dmitriynett-sudo/gitara-els/README.md

# GITARA — Electronic Lead Screw (ELS), электронная гитара для токарного станка

Electronic Lead Screw (ELS), или электронные шестерни для токарного станка, связывает движение продольной каретки с вращением шпинделя и заменяет подбор механических сменных шестерён для подачи и резьбы.

Проект управляет **одной осью — продольной подачей каретки**. Возможности: нарезание и восстановление резьбы, перемещение на заданное расстояние и деление оборота шпинделя.

GITARA управляет шаговым двигателем продольной подачи по энкодеру шпинделя или по заданной скорости. Управление приводом шпинделя и поперечной подачей остаётся у оператора.

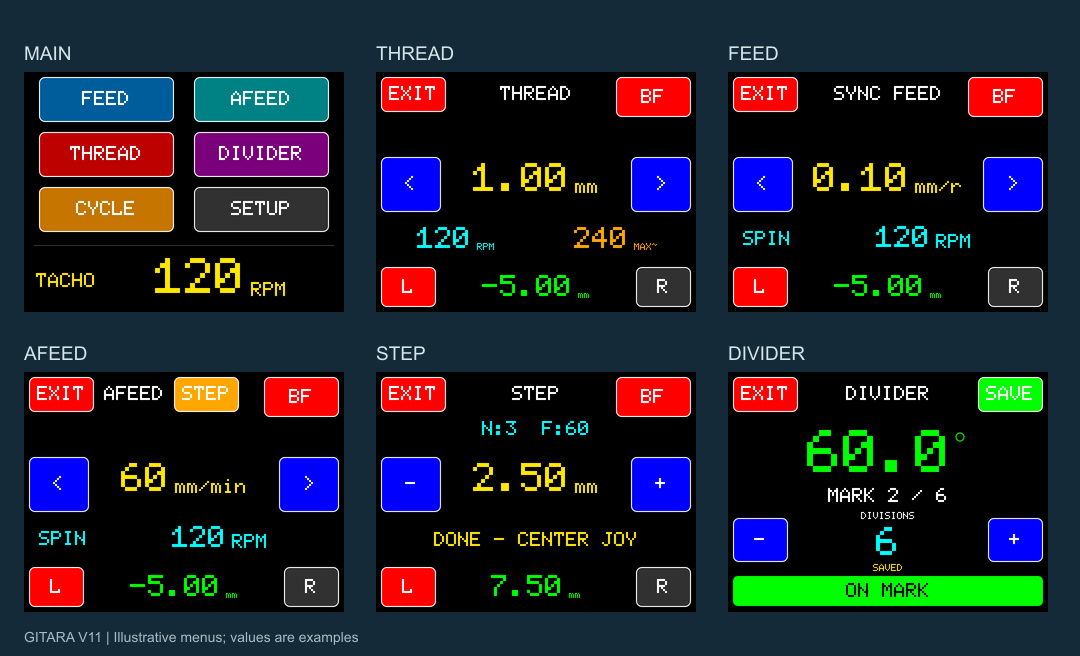
[picture p1: images/menus-v11.png]
Иллюстрации меню GITARA V11


## Документация

- [Фото установки и видео меню на станке](https://dmitriynett-sudo.github.io/gitara-els/#installation) — пример крепления энкодера, передачи продольной подачи и панели управления.

- **[Схема и плата ELS R6: полный проект KiCad, ZIP](hardware/ELS_R6/ELS_R6_KiCad.zip)** — 4 листа схемы, двухслойная плата 58×38 мм и библиотеки компонентов.
- [Схема ELS R6, PDF](hardware/ELS_R6/ELS_R6_Schematic.pdf) · [Файлы KiCad, Gerber и монтажные карты](hardware/ELS_R6/) · [Распиновка разъёмов](hardware/ELS_R6/CONNECTIONS_RU.md).
- Кронштейны: [двигатель NEMA23, DXF](drawings/nema23-bracket.dxf) · [энкодер, DXF](drawings/encoder-bracket.dxf). Единицы — мм; посадочные размеры сверяются со своей механикой.

- **[Открыть виртуальную GITARA V11](https://dmitriynett-sudo.github.io/gitara-els/)** — полный набор меню, настройки, виртуальный шпиндель, джойстик, микроподача и примеры работы. Браузерная модель не управляет станком и не воспроизводит точность/защиту прошивки.
- [Инструкция пользователя V11, PDF](docs/GITARA_V11_User_Guide_RU.pdf) — настройка под свой станок и обзор меню.
- [Сборка и подключение ELS R6](hardware/ELS_R6/README.md) · [Список деталей](hardware/ELS_R6/BOM.csv).
- [Первое включение](docs/QUICK_START_RU.md).
- [Установка готовой прошивки](docs/INSTALL_FIRMWARE_RU.md).
- [Изменения V11](CHANGELOG.md).

Значения на иллюстрациях приведены для примера. Настройки нужно вводить по механике, энкодеру и драйверу своего станка.

## Возможности

| Режим | Назначение |
| --- | --- |
| FEED | Синхронная подача в мм на оборот шпинделя; изменение подачи во время движения. |
| AFEED | Независимая подача в мм/мин. |
| THREAD | Метрические и дюймовые резьбы, правая и левая резьба; сохранение привязки между проходами в выбранном режиме. |
| STEP | Перемещение на заданное расстояние: канавки, шкивы, повторяющиеся операции. |
| DIVIDER | Число делений оборота, угол и звуковое подтверждение попадания на деление. |
| CYCLE | Движение между двумя электронными лимитами с паузой. |
| BF | Компенсация измеренного люфта; мастер начальной настройки. |
| SETUP | Параметры механики, разгон, торможение, диагностика, SD-лог и регистрация. |

## Совместимость

Текущая аппаратная реализация рассчитана на Waveshare RP2350-Touch-LCD-2, квадратурный энкодер A/B и драйвер шагового двигателя с входами STEP/DIR/ENA. Совместимость уровней сигналов и соединения проверяются по паспорту платы и драйвера. Подключение энкодера или драйвера напрямую без проверки уровней может повредить плату.

Нужная плата: **[Waveshare RP2350-Touch-LCD-2, экран 2″ 240×320](https://www.waveshare.com/product/rp2350-touch-lcd-2.htm)**. [Документация и распиновка производителя](https://www.waveshare.com/wiki/RP2350-Touch-LCD-2). Модели 2.1, 2.8 и другие платы не являются заменой для этого UF2.

## Прошивка и активация

**[Скачать GITARA V11 DEMO для RP2350](https://github.com/dmitriynett-sudo/gitara-els/releases/tag/v11-demo-rc1)**. В разделе Assets находятся готовая прошивка UF2, инструкция PDF и контрольные суммы файлов. Для установки скачайте UF2; архивы Source code содержат документацию.

В версии для распространения предусмотрен демонстрационный режим: FEED 0,10 мм/об, AFEED, DIVIDER и THREAD 1,00 мм. Другие шаги резьбы, подачи FEED и режимы STEP/CYCLE открываются активацией для конкретной платы.

Для активации используется DEVICE ID из раздела REGISTER и восьмизначный код, который вводится на экране. Интернет на станке для ввода кода не требуется. Не публикуйте свои коды активации и платёжные данные в Issues.

## Проверка на станке

Перед резанием проверьте направление движения, масштаб DRO и работу лимитов без контакта инструмента с заготовкой. DRO показывает расчётное положение по выданным импульсам; датчика фактического положения каретки нет. Электронные лимиты не заменяют аварийную остановку станка.

## Обратная связь

В Issues можно сообщить о неисправности или предложить улучшение. Укажите версию, режим, настройки механики, выбранную подачу/шаг и порядок воспроизведения. Перед публикацией лога удалите личные данные, идентификаторы плат и коды активации.

## Активация полной версии прошивки

Пользователь самостоятельно собирает устройство и проверяет деморежим. Если прошивка подходит для его задач, он может активировать полную версию.

Стоимость **активации прошивки — 10 долларов**, оплата в **USDT, сеть BNB Smart Chain (BEP20)**. Перед переводом отправьте DEVICE ID из SETUP → REGISTER на [dmitriynet@proton.me](mailto:dmitriynet@proton.me) и согласуйте сумму в USDT. После подтверждения перевода код выдаётся вручную; код привязан к этой плате.

Адрес получения:

`0x5408C962E5A43E652782C84E41e1a12F8a28AdDa`

После оплаты пришлите на почту TXID транзакции и DEVICE ID. Используйте только USDT в BNB Smart Chain; комиссия сети оплачивается отдельно. [Порядок активации на странице проекта](https://dmitriynett-sudo.github.io/gitara-els/#activation).
