dmitriynett-sudo/gitara-els/hardware/ELS_R6/CHECKS_RU.md

# Проверка переноса ELS R6 в KiCad

Проверено в KiCad 10.0.7. Основа - архив ELS_R6_EasyEDA_STD.zip.

- Четыре листа схемы перенесены из EasyEDA в редактируемую схему KiCad.
- Все 169 уникальных выводов совпадают с исходным PIN_NETLIST.csv, включая пять намеренно неподключённых выводов U201.
- Сохранены размещение, геометрия контактных площадок, дорожки, переходные отверстия, зоны меди и контур исходной платы KiCad.
- Добавлены ссылки платы на символы схемы и локальные библиотеки; R238/R239 отмечены DNP. Пяти неподключённым площадкам присвоены стандартные имена KiCad `unconnected-...`.
- DRC: 0 нарушений, 0 неподключённых элементов. Сверка схемы с платой: 0 расхождений.
- ERC: 0 ошибок, 1 предупреждение об одиночной метке ELS_LCD_SCK18 у U201.23. Эта цепь не подключена к внешним деталям, как и в исходном проекте.

Сетка схемы приведена к 50 mil для редактирования в KiCad. Электрические типы выводов
импортированных символов - passive, как в исходных данных: ERC не подтверждает совместимость
напряжений и направления сигналов. CAD-проверки не заменяют электрические испытания устройства и защиты питания.
