dmitriynett-sudo/gitara-els/hardware/ELS_R6/CONNECTIONS_RU.md

# Разъёмы ELS R6

## ELS Pi R6

Разъёмы находятся на TOP — задней стороне. В указанных ниже вертикальных
разъёмах порядок дан **сверху вниз на TOP**. Квадратная площадка — контакт 1.

| Разъём | Контакты | Подписи |
|---|---|---|
| U205 DRIVER | 1 +5V; 2 STEP; 3 ENA; 4 DIR | +5, STP, ENA, DIR слева от контактов |
| U206 ENCODER | 1 +5V; 2 A; 3 B; 4 GND | +5, A, B, GND справа от контактов |
| J204 EXT | 1 3V3; 2 GND; 3 SDA/GP12; 4 SCL/GP13; 5 GP11; 6 GP23; 7 GP21; 8 IN_RESERVED | 3V3, GND, SDA, SCL, GP11, GP23, GP21, IN5 |
| CN201 VIN | TOP слева 1 +36V, справа 2 GND | +36 и GND ниже контактов |

IN5 — вход через согласователь к GPIO5, а не свободный выход процессора.
GPIO11/21/23 доступны при отключённой камере. I²C общий с модулем; уровни 3,3 В.
**R238/R239 (DNP) не устанавливать**: подтяжки уже имеются в Waveshare.
Кнопки и тумблер находятся на BOTTOM. Порядок выводов драйвера и энкодера сохранён.
Питание 36 В подаётся только на CN201 VIN; подавать его на выводы модуля Waveshare и сигнальные разъёмы нельзя.

Монтажные карты показывают позиции деталей. TOP - задняя сторона с разъёмами,
BOTTOM - сторона кнопок и тумблера. Плата Waveshare устанавливается поперёк несущей платы.

Узел защиты R6: выход M201.3 -> F202 -> +5V. Z201: катод (вывод 1, полоса)
к защищённым +5V, анод (вывод 2) к GND. F202 - быстрый 500 мА, не самовосстанавливающийся.
