dmitriynett-sudo/gitara-els/docs/QUICK_START_RU.md

# Первое включение

Полное описание и иллюстрации меню находятся в [инструкции пользователя](GITARA_V11_User_Guide_RU.pdf).

1. Подключите питание, энкодер и драйвер по паспорту платы. Двигатель подключается к драйверу. Установите ток двигателя и делитель микрошага на драйвере.
2. Оставьте джойстик в нейтрали, отведите инструмент от заготовки. В SETUP отключите SIMULATOR.
3. Введите механические параметры:
   - **SCREW PITCH** — шаг обычного однозаходного ходового винта продольной подачи. Винт 2 мм → 2,00. Это не шаг резьбы на заготовке.
   - **MOTOR STEPS** — полные шаги двигателя за оборот: 1,8° → 200; 0,9° → 400.
   - **MICROSTEP** — делитель, установленный на драйвере.
   - **MOTOR GEAR / SCREW GEAR** — зубья на стороне двигателя / винта; для прямого соединения одинаковые числа.
   - **ENC LINES** = паспортные линии энкодера × зубья шкива шпинделя / зубья шкива энкодера. Пример: 1000 × 40 / 20 = 2000. Дополнительно умножать на 2 или 4 не нужно.
4. Сохраните настройки кнопкой SAVE при остановленном шпинделе и отпущенном управлении.
5. В DIVIDER проверьте угол по метке шпинделя: половина оборота — 180°, полный оборот — ровно один круг 0–360°.
6. С BF OFF и BACKLASH = 0 проверьте в AFEED направление и известное расстояние движения. Люфт перед измерением выбирайте движением в ту же сторону. Сравните DRO с измерительным инструментом.
7. Измерьте и настройте BACKLASH. Включение BF — удержание кнопки около 1,2 секунды при отпущенном управлении. Значение уточняйте по индикатору.
8. Задайте безопасные лимиты L/R удержанием соответствующей кнопки около 2,2 секунды. Проверьте остановку до резания. Обнуление DRO, изменение масштаба и перезапуск снимают лимиты.
9. Для резьбы выберите шаг в THREAD, совместите инструмент с началом канавки и проверьте траекторию ручным вращением шпинделя без резания. Повторные проходы выполняются с той же настройкой THREAD и сохранённой привязкой.

Показание MAX в THREAD — расчётный ориентир. Допустимая скорость также зависит от механики, нагрузки, двигателя и драйвера.
