dmitriynett-sudo/gitara-els/hardware/ELS_R6/PCB_TOP.png

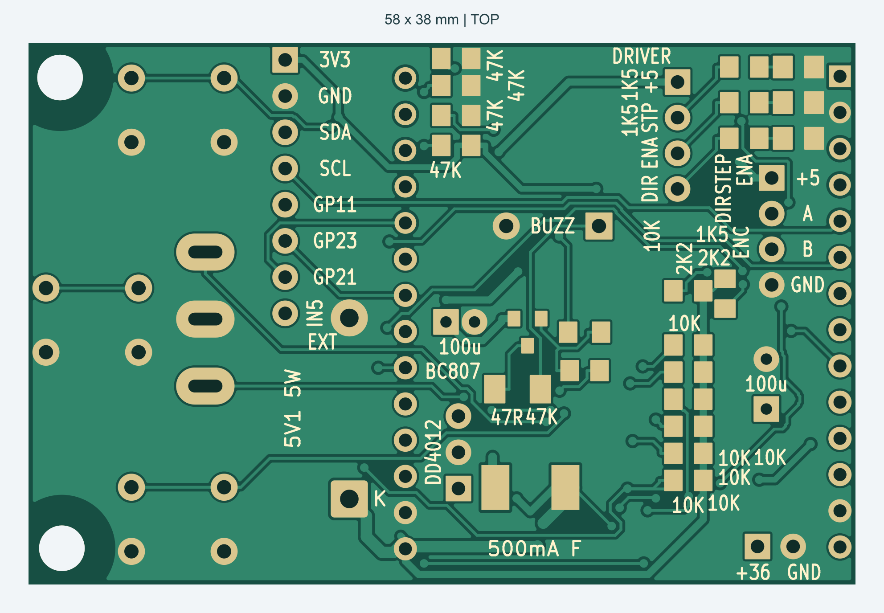
hardware/ELS_R6/PCB_TOP.png
