dmitriynett-sudo/gitara-els/media/lathe-encoder-drive.jpg

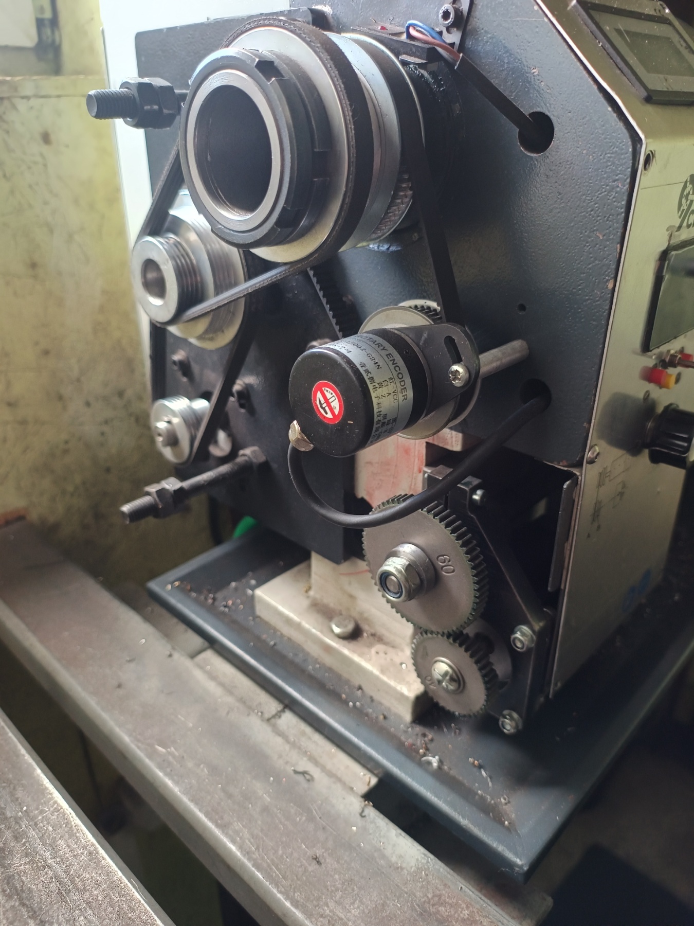
media/lathe-encoder-drive.jpg
