dmitriynett-sudo/gitara-els/media/lathe-menu-poster.jpg

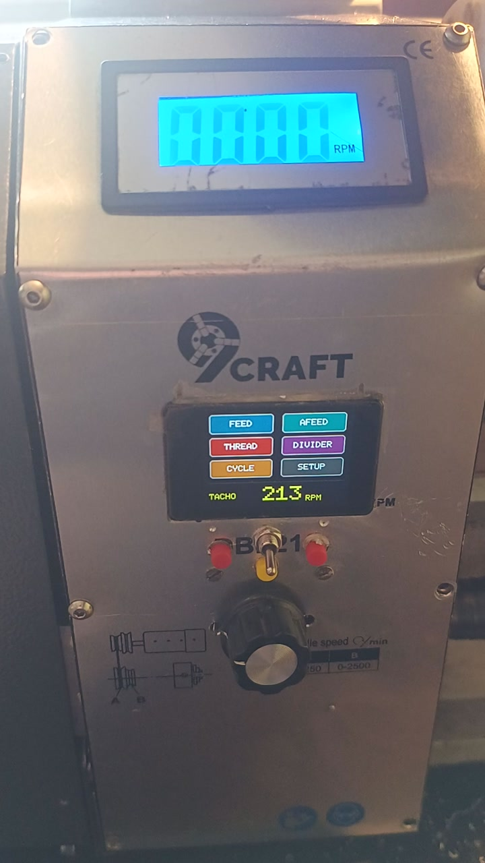
media/lathe-menu-poster.jpg
