dmitriynett-sudo/gitara-els/hardware/ELS_R6/PIN_NETLIST.csv

Reference | Pin | Net
C201 | 1 | GND
C201 | 2 | ELS_+3V3
C202 | 1 | GND
C202 | 2 | ELS_+5V
C203 | 1 | ELS_+5V
C203 | 2 | GND
C204 | 1 | ELS_VIN_FILTERED
C204 | 2 | GND
C205 | 1 | ELS_VIN_FILTERED
C205 | 2 | GND
C206 | 1 | ELS_+5V
C206 | 2 | GND
CN201 | 1 | ELS_VIN_RAW
CN201 | 2 | GND
D201 | 1 | ELS_VIN_FILTERED
D201 | 2 | ELS_VIN_RAW
F202 | 1 | ELS_+5V_RAW
F202 | 2 | ELS_+5V
J204 | 1 | ELS_+3V3
J204 | 2 | GND
J204 | 3 | ELS_I2C_SDA12
J204 | 4 | ELS_I2C_SCL13
J204 | 5 | ELS_GPIO11
J204 | 6 | ELS_GPIO23
J204 | 7 | ELS_GPIO21
J204 | 8 | ELS_IN_RESERVED
LED201 | 1 | GND
LED201 | 2 | ELS_LED_DIR_A
LED202 | 1 | GND
LED202 | 2 | ELS_LED_ENA_A
LED203 | 1 | GND
LED203 | 2 | ELS_LED_STEP_A
M201 | 1 | ELS_VIN_FILTERED
M201 | 2 | GND
M201 | 3 | ELS_+5V_RAW
Q201 | 1 | ELS_BUZZ_BASE
Q201 | 2 | ELS_+5V
Q201 | 3 | ELS_BUZZ_COL
R209 | 1 | ELS_ENC_A_5V
R209 | 2 | ELS_+5V
R210 | 1 | ELS_ENC_B_5V
R210 | 2 | ELS_+5V
R211 | 1 | ELS_MICRO_L
R211 | 2 | ELS_+5V
R212 | 1 | ELS_RAPID
R212 | 2 | ELS_+5V
R213 | 1 | ELS_MICRO_R
R213 | 2 | ELS_+5V
R214 | 1 | ELS_JOY_R
R214 | 2 | ELS_+5V
R215 | 1 | ELS_JOY_L
R215 | 2 | ELS_+5V
R216 | 1 | ELS_IN_RESERVED
R216 | 2 | ELS_+5V
R217 | 1 | ELS_BUZZ_3V3
R217 | 2 | ELS_BUZZ_BUF_IN
R218 | 1 | ELS_DIR_3V3
R218 | 2 | ELS_DIR_BUF_IN
R219 | 1 | ELS_ENA_3V3
R219 | 2 | ELS_ENA_BUF_IN
R220 | 1 | ELS_STEP_3V3
R220 | 2 | ELS_STEP_BUF_IN
R222 | 1 | ELS_DIR_5V
R222 | 2 | ELS_LED_DIR_A
R223 | 1 | ELS_ENA_5V
R223 | 2 | ELS_LED_ENA_A
R224 | 1 | ELS_STEP_5V
R224 | 2 | ELS_LED_STEP_A
R225 | 1 | ELS_STEP_BUF_IN
R225 | 2 | GND
R226 | 1 | ELS_ENA_BUF_IN
R226 | 2 | GND
R227 | 1 | ELS_DIR_BUF_IN
R227 | 2 | GND
R228 | 1 | ELS_BUZZ_BUF_IN
R228 | 2 | ELS_+3V3
R229 | 1 | ELS_BUZZ_DRV
R229 | 2 | ELS_BUZZ_BASE
R230 | 1 | ELS_BUZZ_BASE
R230 | 2 | ELS_+5V
R231 | 1 | ELS_BUZZ_COL
R231 | 2 | ELS_BUZZ_POS
R238 | 1 | ELS_I2C_SDA12
R238 | 2 | ELS_+3V3
R239 | 1 | ELS_I2C_SCL13
R239 | 2 | ELS_+3V3
SG201 | + | ELS_BUZZ_POS
SG201 | - | GND
SW201 | 1 | ELS_MICRO_L
SW201 | 2 | GND
SW202 | 1 | ELS_RAPID
SW202 | 2 | GND
SW203 | 1 | ELS_MICRO_R
SW203 | 2 | GND
U201 | 1 | ELS_+3V3
U201 | 10 | ELS_RAPID_3V3
U201 | 11 | ELS_MICRO_R_3V3
U201 | 12 | ELS_JOY_R_3V3
U201 | 13 | GND
U201 | 14
U201 | 15 | ELS_+5V
U201 | 16 | GND
U201 | 17
U201 | 18
U201 | 19 | ELS_GP5_IN
U201 | 2 | GND
U201 | 20 | ELS_JOY_L_3V3
U201 | 21 | ELS_GPIO11
U201 | 22 | ELS_GPIO23
U201 | 23 | ELS_LCD_SCK18
U201 | 24 | ELS_GPIO21
U201 | 25 | ELS_BUZZ_3V3
U201 | 26 | ELS_DIR_3V3
U201 | 27 | ELS_ENA_3V3
U201 | 28 | ELS_STEP_3V3
U201 | 3
U201 | 4
U201 | 5 | ELS_I2C_SCL13
U201 | 6 | ELS_I2C_SDA12
U201 | 7 | ELS_ENC_A_3V3
U201 | 8 | ELS_ENC_B_3V3
U201 | 9 | ELS_MICRO_L_3V3
U202 | 1 | GND
U202 | 10 | GND
U202 | 11 | ELS_IN_RESERVED
U202 | 12 | ELS_JOY_L
U202 | 13 | ELS_JOY_R
U202 | 14 | ELS_MICRO_R
U202 | 15 | ELS_RAPID
U202 | 16 | ELS_MICRO_L
U202 | 17 | ELS_ENC_B_5V
U202 | 18 | ELS_ENC_A_5V
U202 | 19 | GND
U202 | 2 | ELS_ENC_A_3V3
U202 | 20 | ELS_+3V3
U202 | 3 | ELS_ENC_B_3V3
U202 | 4 | ELS_MICRO_L_3V3
U202 | 5 | ELS_RAPID_3V3
U202 | 6 | ELS_MICRO_R_3V3
U202 | 7 | ELS_JOY_R_3V3
U202 | 8 | ELS_JOY_L_3V3
U202 | 9 | ELS_GP5_IN
U203 | 1 | GND
U203 | 10 | GND
U203 | 11 | ELS_BUZZ_DRV
U203 | 12 | ELS_BUZZ_BUF_IN
U203 | 13 | GND
U203 | 14 | ELS_+5V
U203 | 2 | ELS_STEP_BUF_IN
U203 | 3 | ELS_STEP_5V
U203 | 4 | GND
U203 | 5 | ELS_ENA_BUF_IN
U203 | 6 | ELS_ENA_5V
U203 | 7 | GND
U203 | 8 | ELS_DIR_5V
U203 | 9 | ELS_DIR_BUF_IN
U205 | 1 | ELS_+5V
U205 | 2 | ELS_STEP_5V
U205 | 3 | ELS_ENA_5V
U205 | 4 | ELS_DIR_5V
U206 | 1 | ELS_+5V
U206 | 2 | ELS_ENC_A_5V
U206 | 3 | ELS_ENC_B_5V
U206 | 4 | GND
X1_X201 | 1 | ELS_JOY_L
X1_X201 | 2 | GND
X1_X201 | 3 | ELS_JOY_R
Z201 | 1 | ELS_+5V
Z201 | 2 | GND
