dmitriynett-sudo/gitara-els/drawings/encoder-bracket.dxf

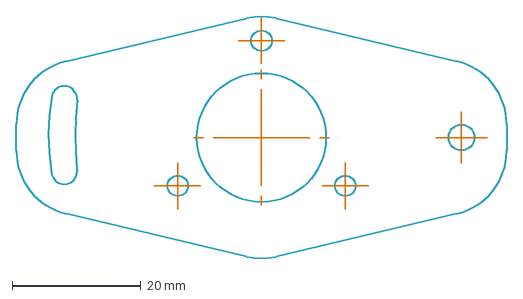
[picture p7: CAD file, 2026-10-11]
drawings/encoder-bracket.dxf
76.0 x 37.6 mm
