dmitriynett-sudo/gitara-els/drawings/nema23-bracket.dxf

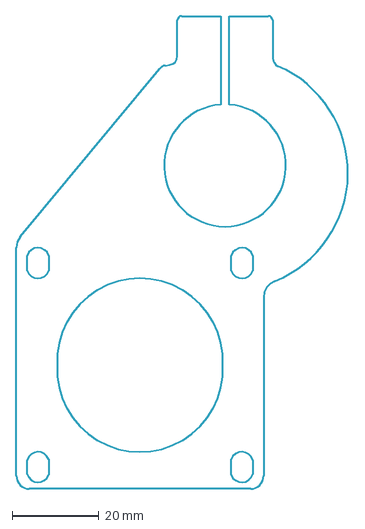
[picture p8: CAD file, 2026-10-11]
drawings/nema23-bracket.dxf
76.6 x 108.9 mm
