dmitriynett-sudo/gitara-els/docs/GITARA_V11_Assembly_RU.pdf

GITARA / V11 | СБОРКА И ПОДКЛЮЧЕНИЕ | ЛИСТ 1/4

# Что подключается к плате

Типовая сборка на Waveshare RP2350-Touch-LCD-2. Рисунок функциональный: расположение контактов сверяйте по надписям GPIO.

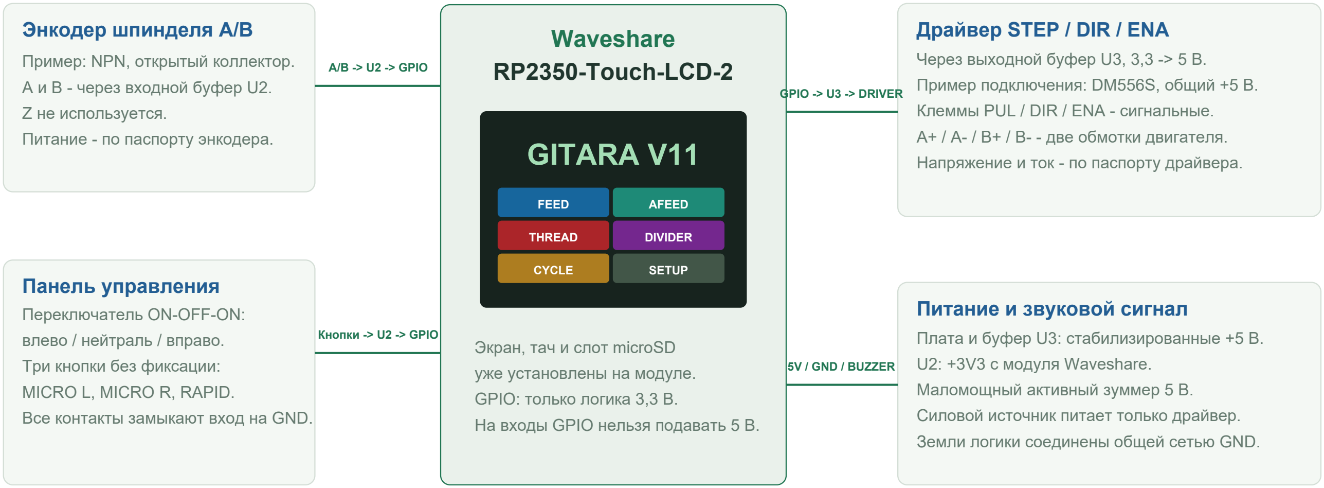
[picture p9: figure]
Энкодер шпинделя A/B; Пример: NPN, открытый коллектор.; A и B - через входной буфер U2.; Z не используется.; Питание - по паспорту энкодера.; Панель управления; Переключатель ON-OFF-ON:; влево / нейтраль / вправо.; Три кнопки без фиксации:; MICRO L, MICRO R, RAPID.; Все контакты замыкают вход на GND.; Waveshare RP2350-Touch-LCD-2; GITARA V11; FEED; AFEED; THREAD; DIVIDER; CYCLE; SETUP; Экран, тач и слот microSD; уже установлены на модуле.; GPIO: только логика 3,3 В.; На входы GPIO нельзя подавать 5 В.; Драйвер STEP / DIR / ENA; Через выходной буфер U3, 3,3 -> 5 В.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

Зелёный: соединения. Оранжевый + *: рекомендуемые доработки. Метки с одним именем - одна сеть. | Формат A3 / 11.10.2026

A+ / A- / B+ / B- - две обмотки двигателя. Напряжение и ток - по паспорту драйвера.

Плата и буфер U3: стабилизированные +5 В.

## Перед подключением

Это монтажная схема конкретной распиновки V11, а не универсальная схема для всех драйверов и энкодеров. Сначала соберите и проверьте цепи +5 В / +3,3 В без силового двигателя. Затем подключайте сигналы. Плату питают либо от USB, либо от внешних +5 В: два независимых источника одновременно не соединять. Для платы с другим размером экрана или другой распиновкой эта схема и опубликованный UF2 не подходят.

GITARA / V11 | СБОРКА И ПОДКЛЮЧЕНИЕ | ЛИСТ 2/4

# Энкодер, кнопки и точные контакты GPIO

U2 = 74LVC245A, VCC = +3,3 В; допустимы входы 5 В. DIR (1) = GND, /OE (19) = GND: направление B -> A.

## U2 / 74LVC245A

Энкодер A

Энкодер B

MICRO L

RAPID

MICRO R

JOY R

JOY L

Резерв (не подключать)

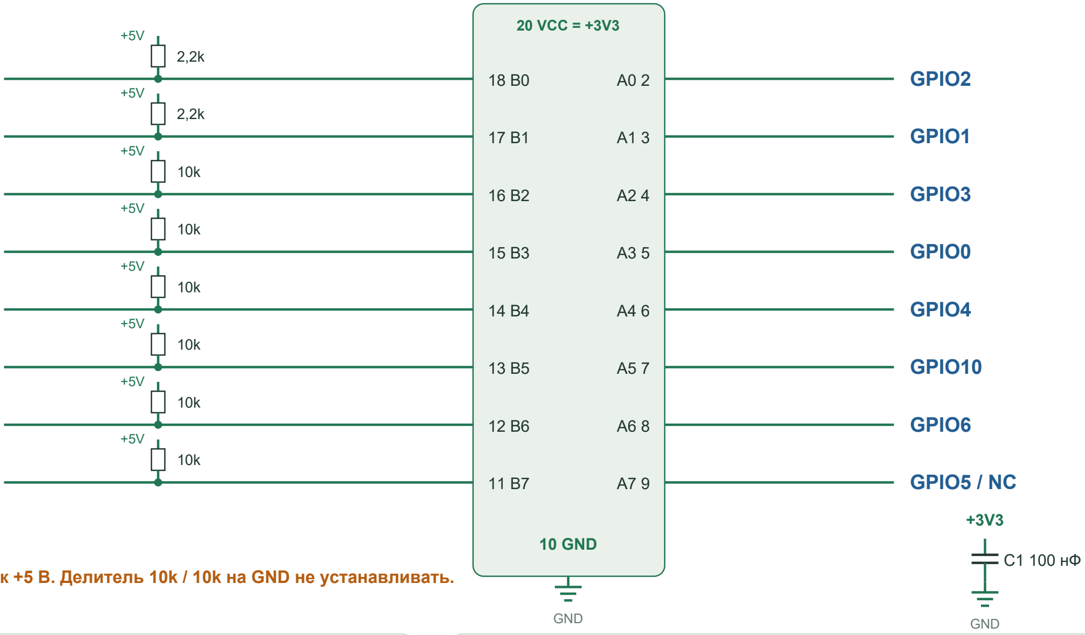
[picture p10: figure]
20 VCC = +3V3; GPIO2; GPIO1; GPIO3; GPIO0; GPIO4; GPIO10; GPIO6; GPIO5 / NC; 10 GND; GND

## Подключение контактов панели

MICRO L/R и RAPID: нормально разомкнутая кнопка -> GND.
JOY L/R: два выхода переключателя, общий контакт -> GND.

В нейтрали оба выхода разомкнуты. +5 В на контакты не подаётся.

## Энкодер NPN / пример Omron E6B2-CWZ6C

Коричневый: +5 В; синий: GND; чёрный: A; белый: B.

Оранжевый Z изолировать. Цвета справедливы только для Omron. Другой тип выхода/питание: согласование подбирать отдельно.

* Резервный B7: одна подтяжка 10k к +5 В. Делитель 10k / 10k на GND не устанавливать.

GITARA / V11 | СБОРКА И ПОДКЛЮЧЕНИЕ | ЛИСТ 3/4

# Выходы STEP / DIR / ENA и зуммер

U3: для новой сборки рекомендован SN74ACT125PW* (TSSOP-14, VCC = 5 В). Номера относятся к корпусу микросхемы, не к GPIO.

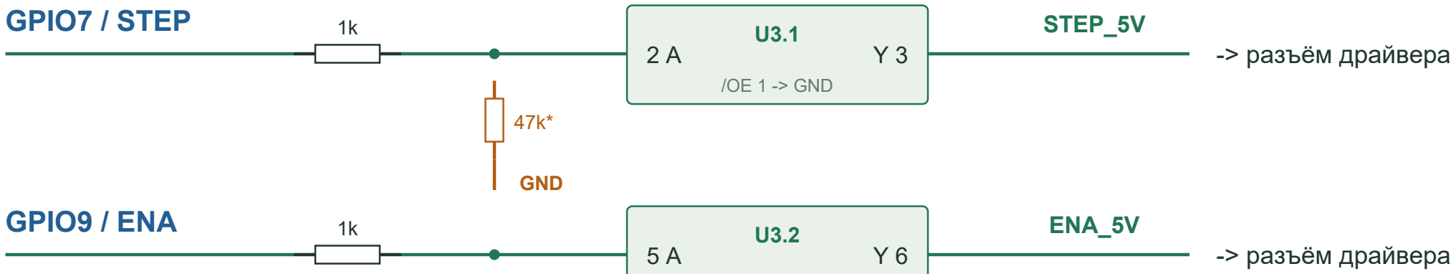
[picture p11: figure]
GPIO7 / STEP; GND; /OE 1 -> GND; STEP_5V; -> разъём драйвера; GPIO9 / ENA; ENA_5V

## U3: питание и выбор

Вывод 14 -> +5V

Вывод 7 -> GND
/OE: 1, 4, 10, 13 -> GND

C2: 100 нФ между 14 и 7,
как можно ближе к корпусу.

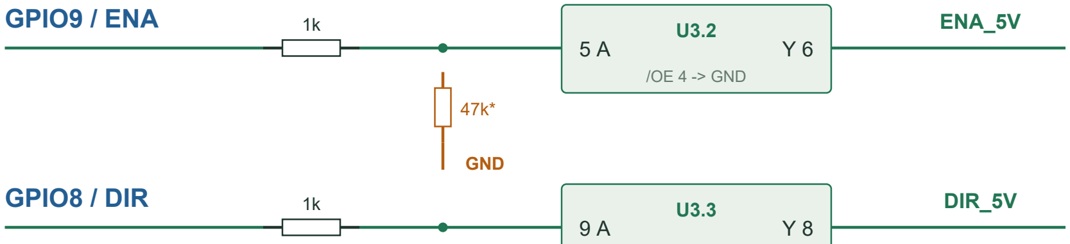
[picture p12: figure]
GND; /OE 4 -> GND; GPIO8 / DIR; DIR_5V

ACT125*: TTL-входы 3,3 В,

выходной ток до 24 мА

в рекомендованном режиме.

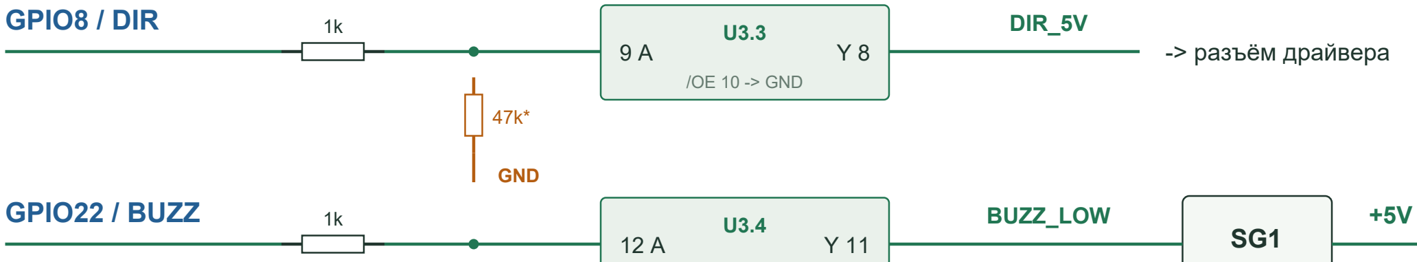
[picture p13: figure]
GND; /OE 10 -> GND; -> разъём драйвера; GPIO22 / BUZZ; BUZZ_LOW

Не путать с HC125/AC125.

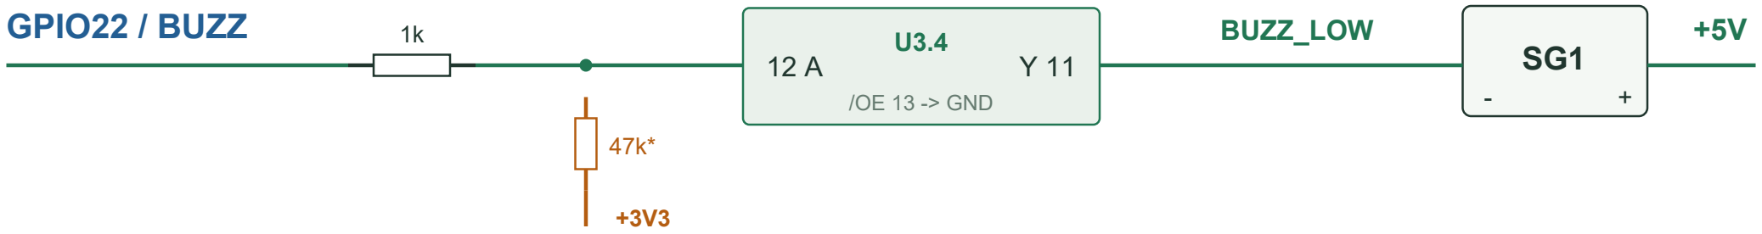
[picture p14: figure]
/OE 13 -> GND

## Зуммер без транзистора

Активный SG1 на 5 В.
LOW на GPIO22 = звук.

Этот вариант: ток SG1 <=8 мА.

Более мощный: нужен ключ.

## * Что изменено для новой сборки

SN74ACT125PW даёт запас тока для оптовходов; для старого AHCT125 сначала измерьте ток входов драйвера. ACT125PW не является прямой корпусной заменой SO-14: нужен подходящий переходник или новая разводка.

Подтяжки 47k*: STEP / ENA / DIR к GND, BUZZ к +3V3. Они задают состояние входов U3 до запуска программы.

GITARA / V11 | СБОРКА И ПОДКЛЮЧЕНИЕ | ЛИСТ 4/4

# Драйвер, питание и проверка после сборки

Показан пример DM556S с оптовходами и общим плюсом +5 В. Для другого драйвера проверьте его паспорт, ток и полярность ENA.

PUL+ / DIR+ / ENA+ -> +5V.

PUL- -> STEP_5V.

DIR- -> DIR_5V.

ENA- -> ENA_5V.

Для DM556S V11:
GPIO9 HIGH = драйвер включён.

Перед подключением двигателя

проверьте фактическое ENA.

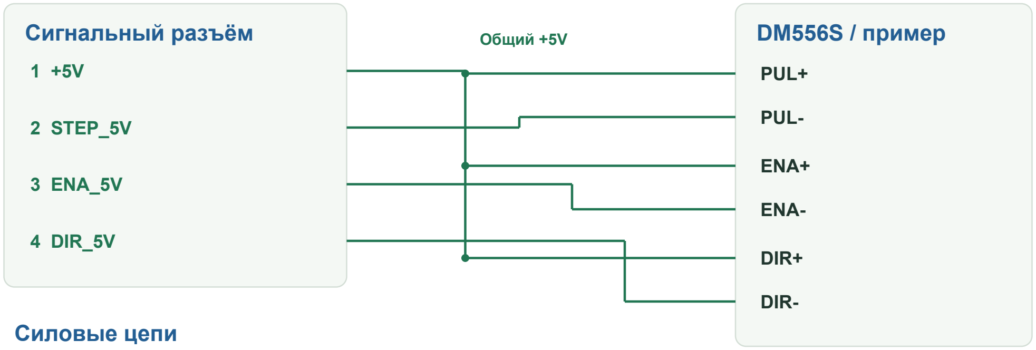
[picture p15: figure]
Сигнальный разъём; 2 STEP_5V; 3 ENA_5V; 4 DIR_5V; DM556S / пример; PUL+; PUL-; ENA+; ENA-; DIR+; DIR-; Общий +5V; Силовые цепи

## БП драйвера

VDC+ / VDC- -> питание DM556S.

Диапазон: по паспорту драйвера.

## Шаговый двигатель

Обмотка 1 -> A+ / A-.

Обмотка 2 -> B+ / B-.

## Отдельные стабилизированные +5 В*

+5 В -> контакт 5V платы, U3, подтяжки и SG1.

GND -> плата, U2, U3, панель, энкодер и источник.

## Порядок первого включения

1. Без драйвера: измерьте +5 В и +3,3 В, проверьте отсутствие короткого замыкания и SIMULATOR OFF.
2. В HW MONITOR проверьте A/B, джойстик, MICRO L/R и RAPID. Энкодер вращайте рукой.
3. При отключённом силовом питании подключите драйвер и двигатель. Микрошаг в драйвере и SETUP должен совпадать.
4. Без резания проверьте направление и масштаб DRO по индикатору, затем BF, оба лимита и аварийную остановку.

* Для новой сборки проще отдельное питание 5 В. Если брать 5 В от силовой шины, нужен DC/DC с запасом по входным выбросам.
Не подключать USB 5 В и внешние 5 В одновременно. Не подключать / отключать обмотки при включённом драйвере.
Waveshare: плата (https://www.waveshare.com/product/rp2350-touch-lcd-2.htm) | Waveshare: схема (https://files.waveshare.com/wiki/RP2350-Touch-LCD-2/RP2350-Touch-LCD-2.pdf) | Nexperia: LVC245A (https://assets.nexperia.com/documents/data-sheet/74LVC_LVCH245A.pdf) | TI: ACT125 (https://www.ti.com/lit/gpn/SN74ACT125) | DM556S: руководство (https://www.leadtronker.com/Documents/Manuals/CN/DM556S_UM_cn.pdf)
