dmitriynett-sudo/gitara-els/docs/INSTALL_FIRMWARE_RU.md

# Готовая прошивка

[Скачать прошивку V11 DEMO](https://github.com/dmitriynett-sudo/gitara-els/releases/tag/v11-demo-rc1) для Waveshare RP2350-Touch-LCD-2. Файл: `GITARA_V11_DEMO_RP2350.uf2`.

## Перед установкой

- Проверьте название поддерживаемой платы и требования конкретного релиза.
- Запишите настройки механики и драйвера. После установки проверьте сохранённые значения. На ранее активированной плате статус ACTIVE может сохраниться.
- Остановите станок и исключите неожиданное движение: переводите плату в режим загрузки только при обесточенном силовом драйвере.

## Порядок установки

1. Скачайте файл `.uf2` из раздела Assets. При необходимости проверьте его по контрольной сумме в `SHA256SUMS.txt` из того же выпуска.
2. Переведите плату в USB-режим BOOT согласно её паспорту. Не меняйте подключение питания или BOOT наугад.
3. Скопируйте UF2 на появившийся загрузочный USB-диск. После записи плата обычно перезапускается.
4. Проверьте версию, механические настройки, SIMULATOR OFF и статус активации. Выполните проверку направления, перемещения и лимитов без резания.

Не загружайте UF2 для другой платы. Не применяйте полное стирание flash без понимания последствий для сохранённых настроек и активации.

## Активация

Откройте SETUP → REGISTER, сообщите продавцу DEVICE ID, получите код для этой платы и введите все восемь цифр, включая начальные нули. ACTIVE означает принятую активацию.
