dmitriynett-sudo/gitara-els/CHANGELOG.md

# Изменения

## V11

- FEED меняет подачу на ходу без промежуточной остановки; переход к новой подаче занимает примерно 120 мс.
- Состояние BF ON/OFF сохраняется после остановки. Перед выключением питания отпустите управление, остановите шпиндель, выключите SIMULATOR и подождите около двух секунд.
- DEVICE ID отображается в REGISTER; дублирование в SETUP убрано.
- SD-лог V11 записывается в `phase11.txt`. Диагностика остановок дополнена RPM и состоянием SIMULATOR.
- Инструкция уточняет SCREW PITCH как шаг обычного однозаходного винта продольной подачи, а ENC LINES — как линии энкодера с учётом передачи от шпинделя.
