dmitriynett-sudo/gitara-els/docs/GITARA_V11_Schematic_RU.pdf

## ЭНКОДЕР И ВХОДЫ 5 В → 3,3 В

U6

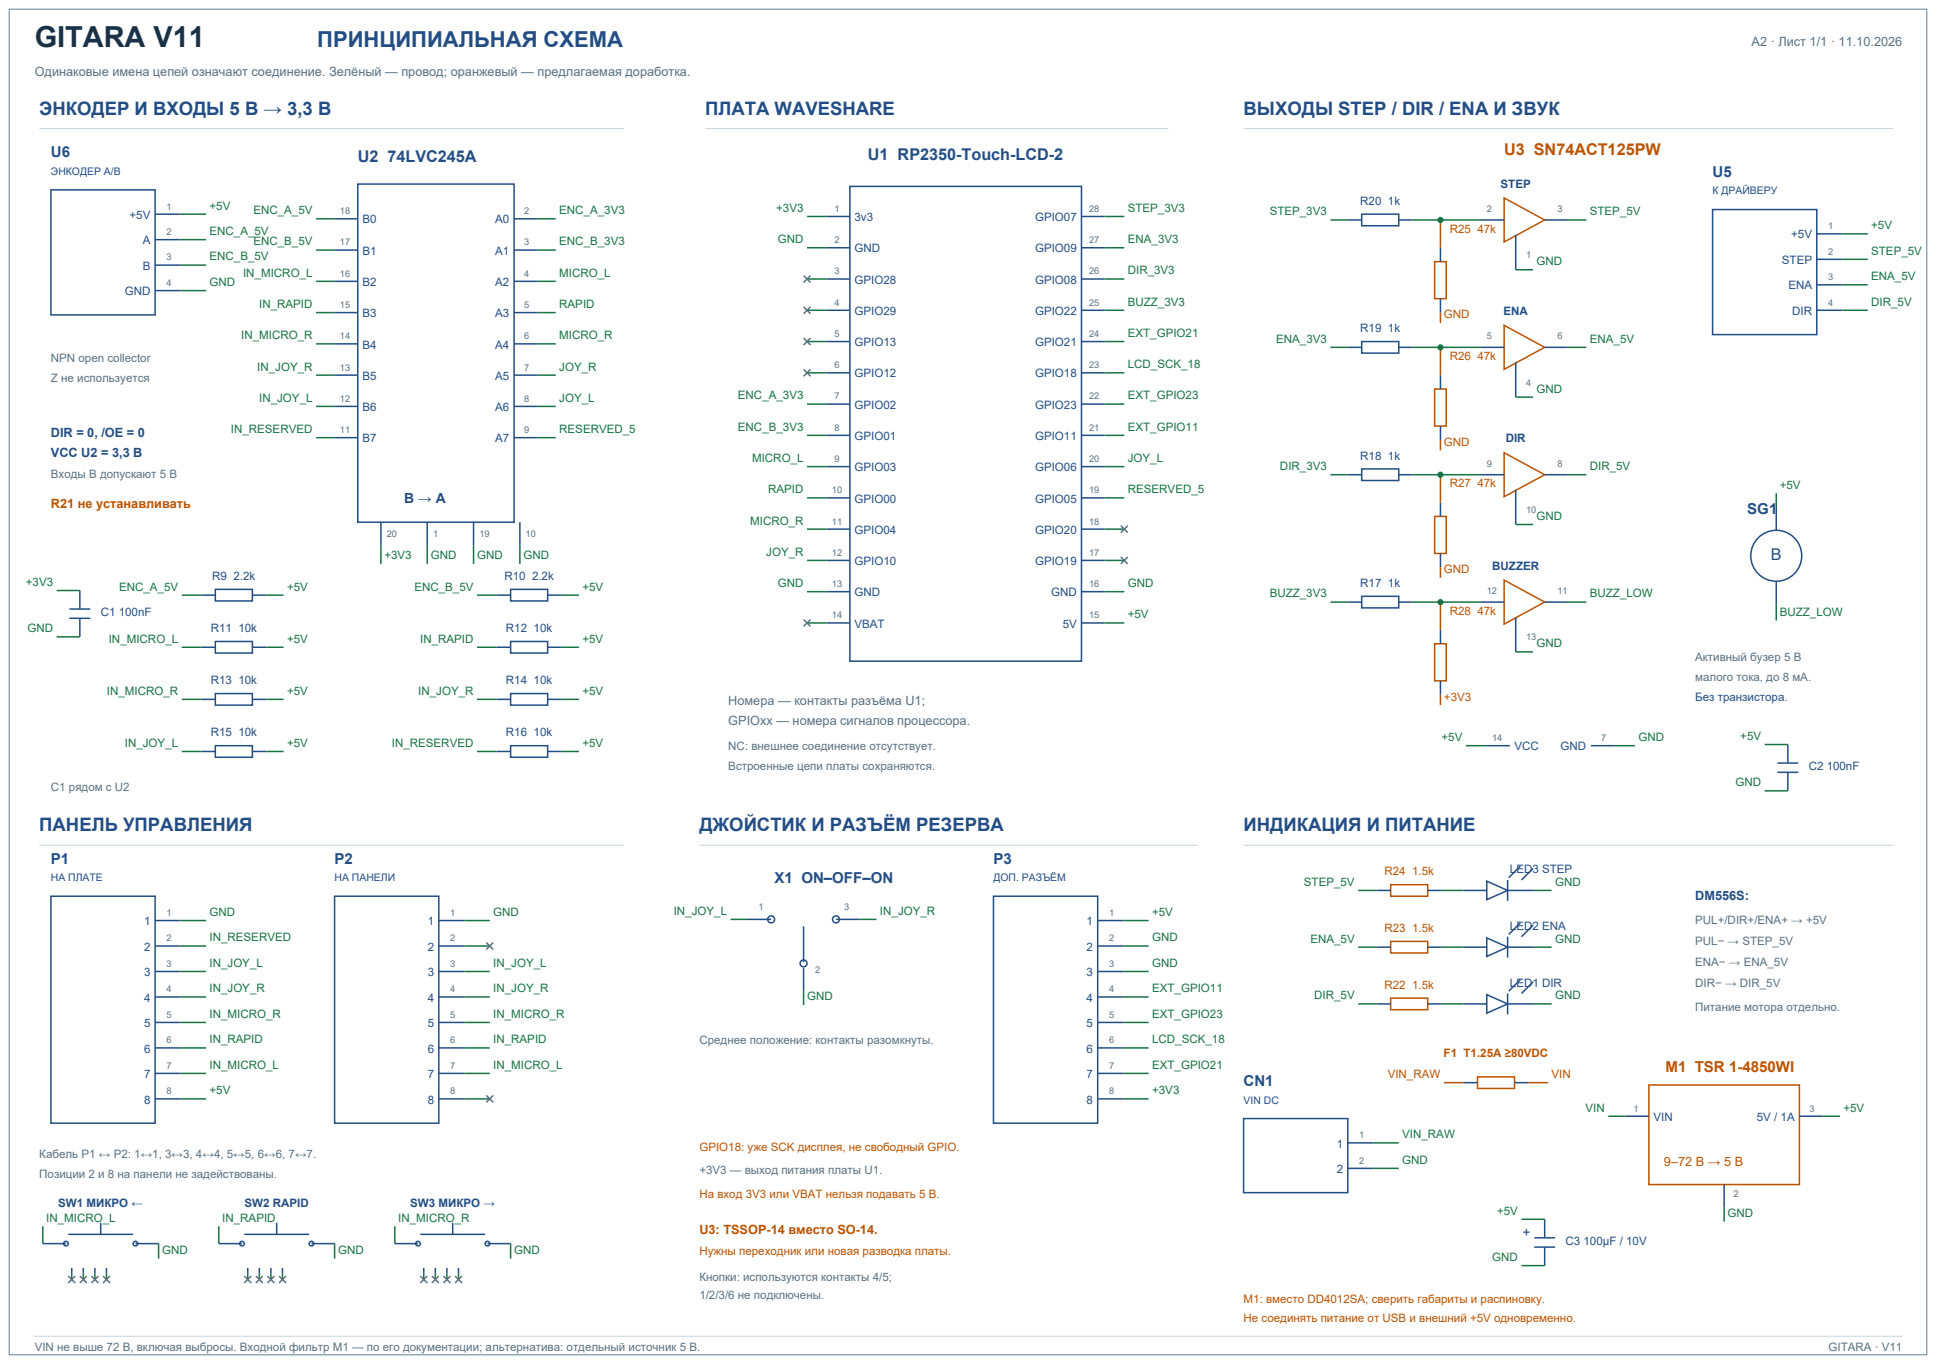
[picture p32: page 1]

Одинаковые имена цепей означают соединение. Зелёный — провод; оранжевый — предлагаемая доработка.

ВЫХОДЫ STEP / DIR / ENA И ЗВУК

Активный бузер 5 В
малого тока, до 8 мА.
Без транзистора.

Номера — контакты разъёма U1;
GPIOxx — номера сигналов процессора.

NC: внешнее соединение отсутствует.
Встроенные цепи платы сохраняются.

Среднее положение: контакты разомкнуты.

GPIO18: уже SCK дисплея, не свободный GPIO.

Кабель P1 ↔ P2: 1↔1, 3↔3, 4↔4, 5↔5, 6↔6, 7↔7.
Позиции 2 и 8 на панели не задействованы.

На вход 3V3 или VBAT нельзя подавать 5 В.

Нужны переходник или новая разводка платы.

M1: вместо DD4012SA; сверить габариты и распиновку.
Не соединять питание от USB и внешний +5V одновременно.
