dmitriynett-sudo/gitara-els/(list of files, drawings)

Other design files:
docs/GITARA_V11_Schematic_EasyEDA.json
