dmitriynett-sudo/gitara-els/(commit log)

2026-10-11 Add V11 assembly diagram and connection guide
2026-10-11 Add vector assembly overview
2026-10-11 Keep installation and assembly guides focused on users
2026-10-11 Add readable circuit schematic and EasyEDA source
    [GITARA_V11_Schematic_EasyEDA.json]
2026-10-11 Add vector preview of the complete circuit
2026-10-11 Add NEMA23 and encoder bracket drawings
    [encoder-bracket.dxf, nema23-bracket.dxf]
2026-10-11 Add activation information, assembly downloads and search metadata
2026-10-19 Publish complete ELS R6 KiCad hardware package
    Includes four-sheet native schematic, original PCB layout, local libraries, PDF, BOM, assembly maps and Gerber. Verified netlist, PCB DRC and schematic parity.
    [BOM.csv, BOM_without_resistors_capacitors.csv, PIN_NETLIST.csv]
2026-10-19 Add ELS R6 KiCad downloads to the project page
